solderneer/SimpleMP4/README.md

# SimpleMP4
A custom MP4 player designed based on the Rockwell RK2608 dedicated IC.

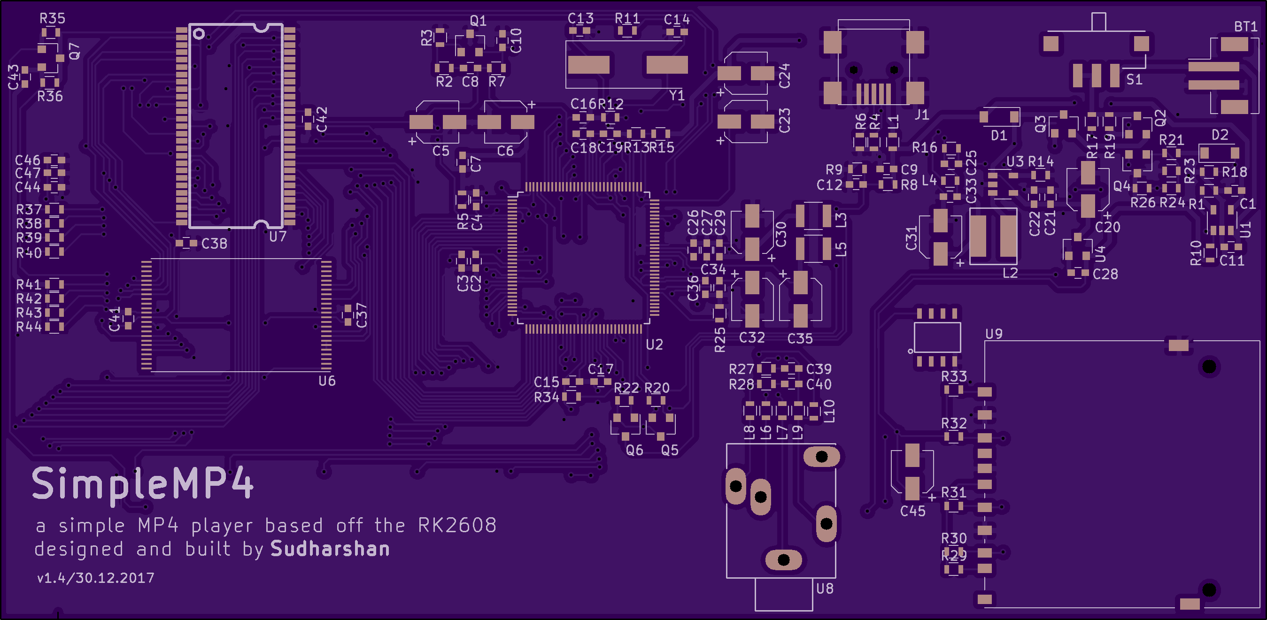
[picture p1: renders/v1.0.0_top.png]
