solderneer/SimpleMP4/renders/v1.0.0_bot.png

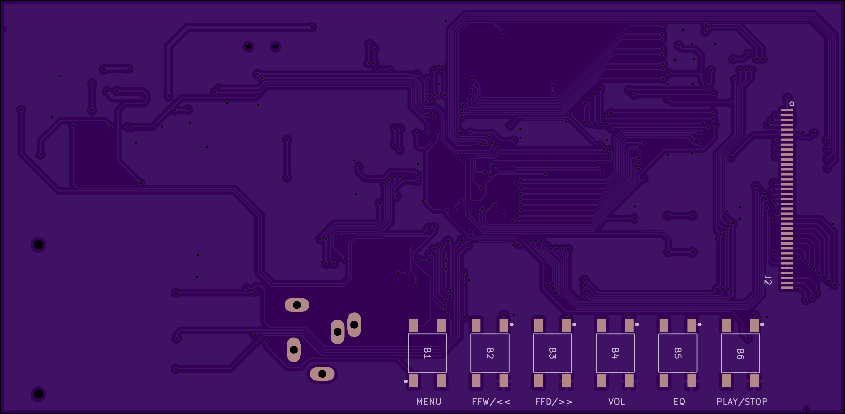
renders/v1.0.0_bot.png
