solderneer/SimpleMP4/electronics/bom/SimpleMP4.csv

Reference | Value | Footprint | Datasheet | Digikey | Quantity | 1276-1021-1-ND | 1
B1 | PLAY/STOP | footprints:SW_HP0315AFKP4-R | SKHLAAA010 | 360-2596-1-ND | 1 | 1N4148W-FDIDKR-ND | 1
B2 | EQ | footprints:SW_HP0315AFKP4-R | SKHLAAA010 | 360-2596-1-ND | 1 | 1N5819HW-FDICT-ND | 1
B3 | VOL | footprints:SW_HP0315AFKP4-R | SKHLAAA010 | 360-2596-1-ND | 1 | 308-1527-1-ND | 1
B4 | FFD/>> | footprints:SW_HP0315AFKP4-R | SKHLAAA010 | 360-2596-1-ND | 1 | 311-10KDCT-ND | 7
B5 | FFW/<< | footprints:SW_HP0315AFKP4-R | SKHLAAA010 | 360-2596-1-ND | 1 | 360-2596-1-ND | 6
B6 | MENU | footprints:SW_HP0315AFKP4-R | SKHLAAA010 | 360-2596-1-ND | 1 | 360-2924-1-ND | 1
BT1 | LI-3.6V | footprints:JST_PH_B2B-PH-SM4-TB_02x2.00mm_Straight |  | 455-1734-2-ND | 1 | 399-1095-1-ND | 23
C1 | 1uF | footprints:C_0603 |  | 399-3118-1-ND | 1 | 399-3118-1-ND | 4
C10 | 0.1uF | footprints:C_0603 |  | 399-1095-1-ND | 1 | 399-9096-1-ND | 2
C11 | 1uF | footprints:C_0603 |  | 399-3118-1-ND | 1 | 445-1272-1-ND | 2
C12 | 0.1uF | footprints:C_0603 |  | 399-1095-1-ND | 1 | 455-1734-2-ND | 1
C13 | 8pF | footprints:C_0603 |  | 445-1272-1-ND | 1 | 478-1227-1-ND | 4
C14 | 8pF | footprints:C_0603 |  | 445-1272-1-ND | 1 | 490-14398-2-ND | 7
C15 | 0.1uF | footprints:C_0603 |  | 399-1095-1-ND | 1 | 535-10233-1-ND | 1
C16 | 0.1uF | footprints:C_0603 |  | 399-1095-1-ND | 1 | 587-3064-1-ND | 2
C17 | 0.1uF | footprints:C_0603 |  | 399-1095-1-ND | 1 | 609-3956-1-ND | 1
C18 | 0.1uF | footprints:C_0603 |  | 399-1095-1-ND | 1 | 609-4700-2-ND | 1
C19 | 1uF | footprints:C_0603 |  | 399-3118-1-ND | 1 | A103049TR-ND | 2
C2 | 0.1uF | footprints:C_0603 |  | 399-1095-1-ND | 1 | A119955TR-ND | 4
C20 | 22uF | footprints:CP_Elec_4x4.5 |  | PCE3857CT-ND | 1 | A119962CT-ND | 1
C21 | 0.1uF | footprints:C_0603 |  | 399-1095-1-ND | 1 | AP2210N-3.3TRG1DICT-ND | 1
C22 | 10nF | footprints:C_0603 |  | 478-1227-1-ND | 1 | MCT0603-33.0-CFCT-ND | 4
C23 | 10uF | footprints:CP_Elec_4x4.5 |  | PCE3878CT-ND | 1 | P12KDBCT-ND | 1
C24 | 10uF | footprints:CP_Elec_4x4.5 |  | PCE3878CT-ND | 1 | P150KDBCT-ND | 1
C25 | 30pF | footprints:C_0603 |  | 1276-1021-1-ND | 1 | P4.7KDBCT-ND | 1
C26 | 0.1uF | footprints:C_0603 |  | 399-1095-1-ND | 1 | P47KDBCT-ND | 8
C27 | 0.1uF | footprints:C_0603 |  | 399-1095-1-ND | 1 | P56KDBCT-ND | 1
C28 | 1uF | footprints:C_0603 |  | 399-3118-1-ND | 1 | PCE3857CT-ND | 11
C29 | 0.1uF | footprints:C_0603 |  | 399-1095-1-ND | 1 | RR08P1.0KDCT-ND | 1
C3 | 0.1uF | footprints:C_0603 |  | 399-1095-1-ND | 1 | RR08P100KDCT-ND | 8
C30 | 10uF | footprints:CP_Elec_4x4.5 |  | PCE3878CT-ND | 1 | RR08P220KDCT-ND | 1
C31 | 10uF | footprints:CP_Elec_4x4.5 |  | PCE3878CT-ND | 1 | WM13342-ND | 1
C32 | 10uF | footprints:CP_Elec_4x4.5 |  | PCE3878CT-ND | 1 |  | 112
C33 | 10nF | footprints:C_0603 |  | 478-1227-1-ND | 1
C34 | 0.1uF | footprints:C_0603 |  | 399-1095-1-ND | 1
C35 | 10uF | footprints:CP_Elec_4x4.5 |  | PCE3878CT-ND | 1
C36 | 0.1uF | footprints:C_0603 |  | 399-1095-1-ND | 1
C37 | 0.1uF | footprints:C_0603 |  | 399-1095-1-ND | 1
C38 | 0.1uF | footprints:C_0603 |  | 399-1095-1-ND | 1
C39 | 47nF | footprints:C_0603 |  | 399-9096-1-ND | 1
C4 | 10nF | footprints:C_0603 |  | 478-1227-1-ND | 1
C40 | 47nF | footprints:C_0603 |  | 399-9096-1-ND | 1
C41 | 0.1uF | footprints:C_0603 |  | 399-1095-1-ND | 1
C42 | 0.1uF | footprints:C_0603 |  | 399-1095-1-ND | 1
C43 | 0.1uF | footprints:C_0603 |  | 399-1095-1-ND | 1
C44 | 0.1uF | footprints:C_0603 |  | 399-1095-1-ND | 1
C45 | 10uF | footprints:CP_Elec_4x4.5 |  | PCE3878CT-ND | 1
C46 | 0.1uF | footprints:C_0603 |  | 399-1095-1-ND | 1
C47 | 10uF | footprints:C_0603 |  | PCE3878CT-ND | 1
C5 | 22uF | footprints:CP_Elec_4x4.5 |  | PCE3857CT-ND | 1
C6 | 22uF | footprints:CP_Elec_4x4.5 |  | PCE3857CT-ND | 1
C7 | 10nF | footprints:C_0603 |  | 478-1227-1-ND | 1
C8 | 0.1uF | footprints:C_0603 |  | 399-1095-1-ND | 1
C9 | 0.1uF | footprints:C_0603 |  | 399-1095-1-ND | 1
D1 | 1N5819 | footprints:D_SOD-123 |  | 1N5819HW-FDICT-ND | 1
D2 | 1N4148 | footprints:D_SOD-123 |  | 1N4148W-FDIDKR-ND | 1
J1 | CONN USB MICRO B | footprints:USB_Mini-B |  | 609-4700-2-ND | 1
J2 | DISPLAY | footprints:KD024B |  | WM13342-ND | 1
L1 | 600R/100M | footprints:L_0603 |  | 490-14398-2-ND | 1
L10 | 600R/100M | footprints:L_0603 |  | 490-14398-2-ND | 1
L2 | 4.7uH | footprints:CR43NP-4R7MC |  | 308-1527-1-ND | 1
L3 | 10uH | footprints:L_1210 |  | 587-3064-1-ND | 1
L4 | 600R/100M | footprints:L_0603 |  | 490-14398-2-ND | 1
L5 | 10uH | footprints:L_1210 |  | 587-3064-1-ND | 1
L6 | 600R/100M | footprints:L_0603 |  | 490-14398-2-ND | 1
L7 | 600R/100M | footprints:L_0603 |  | 490-14398-2-ND | 1
L8 | 600R/100M | footprints:L_0603 |  | 490-14398-2-ND | 1
L9 | 600R/100M | footprints:L_0603 |  | 490-14398-2-ND | 1
R1 | 4.7K | footprints:R_0603 |  | P4.7KDBCT-ND | 1
R10 | 100K | footprints:R_0603 |  | RR08P100KDCT-ND | 1
R11 | 1M | footprints:R_0603 |  | A119955TR-ND | 1
R12 | 100K | footprints:R_0603 |  | RR08P100KDCT-ND | 1
R13 | 100K | footprints:R_0603 |  | RR08P100KDCT-ND | 1
R14 | 150K* | footprints:R_0603 |  | P150KDBCT-ND | 1
R15 | 100K | footprints:R_0603 |  | RR08P100KDCT-ND | 1
R16 | 390K | footprints:R_0603 |  | A119962CT-ND | 1
R17 | 10K | footprints:R_0603 |  | 311-10KDCT-ND | 1
R18 | 100K | footprints:R_0603 |  | RR08P100KDCT-ND | 1
R19 | 100K | footprints:R_0603 |  | RR08P100KDCT-ND | 1
R2 | 220K | footprints:R_0603 |  | RR08P220KDCT-ND | 1
R20 | 1K | footprints:R_0603 |  | RR08P1.0KDCT-ND | 1
R21 | 47K | footprints:R_0603 |  | P47KDBCT-ND | 1
R22 | 100K | footprints:R_0603 |  | RR08P100KDCT-ND | 1
R23 | 100K | footprints:R_0603 |  | RR08P100KDCT-ND | 1
R24 | 47K | footprints:R_0603 |  | P47KDBCT-ND | 1
R25 | 56K/1% | footprints:R_0603 |  | P56KDBCT-ND | 1
R26 | 10K | footprints:R_0603 |  | 311-10KDCT-ND | 1
R27 | 16 | footprints:R_0603 |  | A103049TR-ND | 1
R28 | 16 | footprints:R_0603 |  | A103049TR-ND | 1
R29 | 47K | footprints:R_0603 |  | P47KDBCT-ND | 1
R3 | 1M | footprints:R_0603 |  | A119955TR-ND | 1
R30 | 47K | footprints:R_0603 |  | P47KDBCT-ND | 1
R31 | 47K | footprints:R_0603 |  | P47KDBCT-ND | 1
R32 | 47K | footprints:R_0603 |  | P47KDBCT-ND | 1
R33 | 47K | footprints:R_0603 |  | P47KDBCT-ND | 1
R34 | 47K | footprints:R_0603 |  | P47KDBCT-ND | 1
R35 | 10K | footprints:R_0603 |  | 311-10KDCT-ND | 1
R36 | 10K | footprints:R_0603 |  | 311-10KDCT-ND | 1
R37 | 33R | footprints:R_0603 |  | MCT0603-33.0-CFCT-ND | 1
R38 | 33R | footprints:R_0603 |  | MCT0603-33.0-CFCT-ND | 1
R39 | 33R | footprints:R_0603 |  | MCT0603-33.0-CFCT-ND | 1
R4 | 1M | footprints:R_0603 |  | A119955TR-ND | 1
R40 | 33R | footprints:R_0603 |  | MCT0603-33.0-CFCT-ND | 1
R41 | R* | footprints:R_0603 |  |  | 1
R42 | R* | footprints:R_0603 |  |  | 1
R43 | R* | footprints:R_0603 |  |  | 1
R44 | R* | footprints:R_0603 |  |  | 1
R5 | 10K | footprints:R_0603 |  | 311-10KDCT-ND | 1
R6 | 1M | footprints:R_0603 |  | A119955TR-ND | 1
R7 | 10K | footprints:R_0603 |  | 311-10KDCT-ND | 1
R8 | 10K | footprints:R_0603 |  | 311-10KDCT-ND | 1
R9 | 12K | footprints:R_0603 |  | P12KDBCT-ND | 1
S1 | ON/OFF | footprints:SW_SS312SAH4-R | NKK Switches | 360-2924-1-ND | 1
U1 | OCP8020 | footprints:SOT-23-5 |  |  | 1
U2 | RK2608 | footprints:LQFP-128_14x14mm_Pitch0.4mm | DOCUMENTATION |  | 1
U3 | OCP2150TW18A | footprints:SOT-23-5 |  |  | 1
U4 | OCP1240 | footprints:SOT-23 |  | AP2210N-3.3TRG1DICT-ND | 1
U5 | MT25QL128ABA | footprints:SOP-8 |  |  | 1
U6 | IS34ML04G081-TLI | footprints:TSOP-I-48_18.4x12mm_Pitch0.5mm | DOCUMENTATION |  | 1
U7 | K4S641632N | footprints:TSOP-54 | DOCUMENTATION |  | 1
U8 | TRS_5PIN | footprints:Stereo_Jack_3.5mm_Switch_Ledino_KB3SPRS |  |  | 1
U9 | MMC/SD_SOCKET | footprints:SD_Card_Receptacle |  | 609-3956-1-ND | 1
Y1 | 24MHz | footprints:Crystal_SMD_HC49-SD |  | 535-10233-1-ND | 1
