solderneer/SimpleMP4/electronics/SimpleMP4.kicad_pcb

## KiCad design electronics/SimpleMP4.kicad_pcb (2018-01-05)

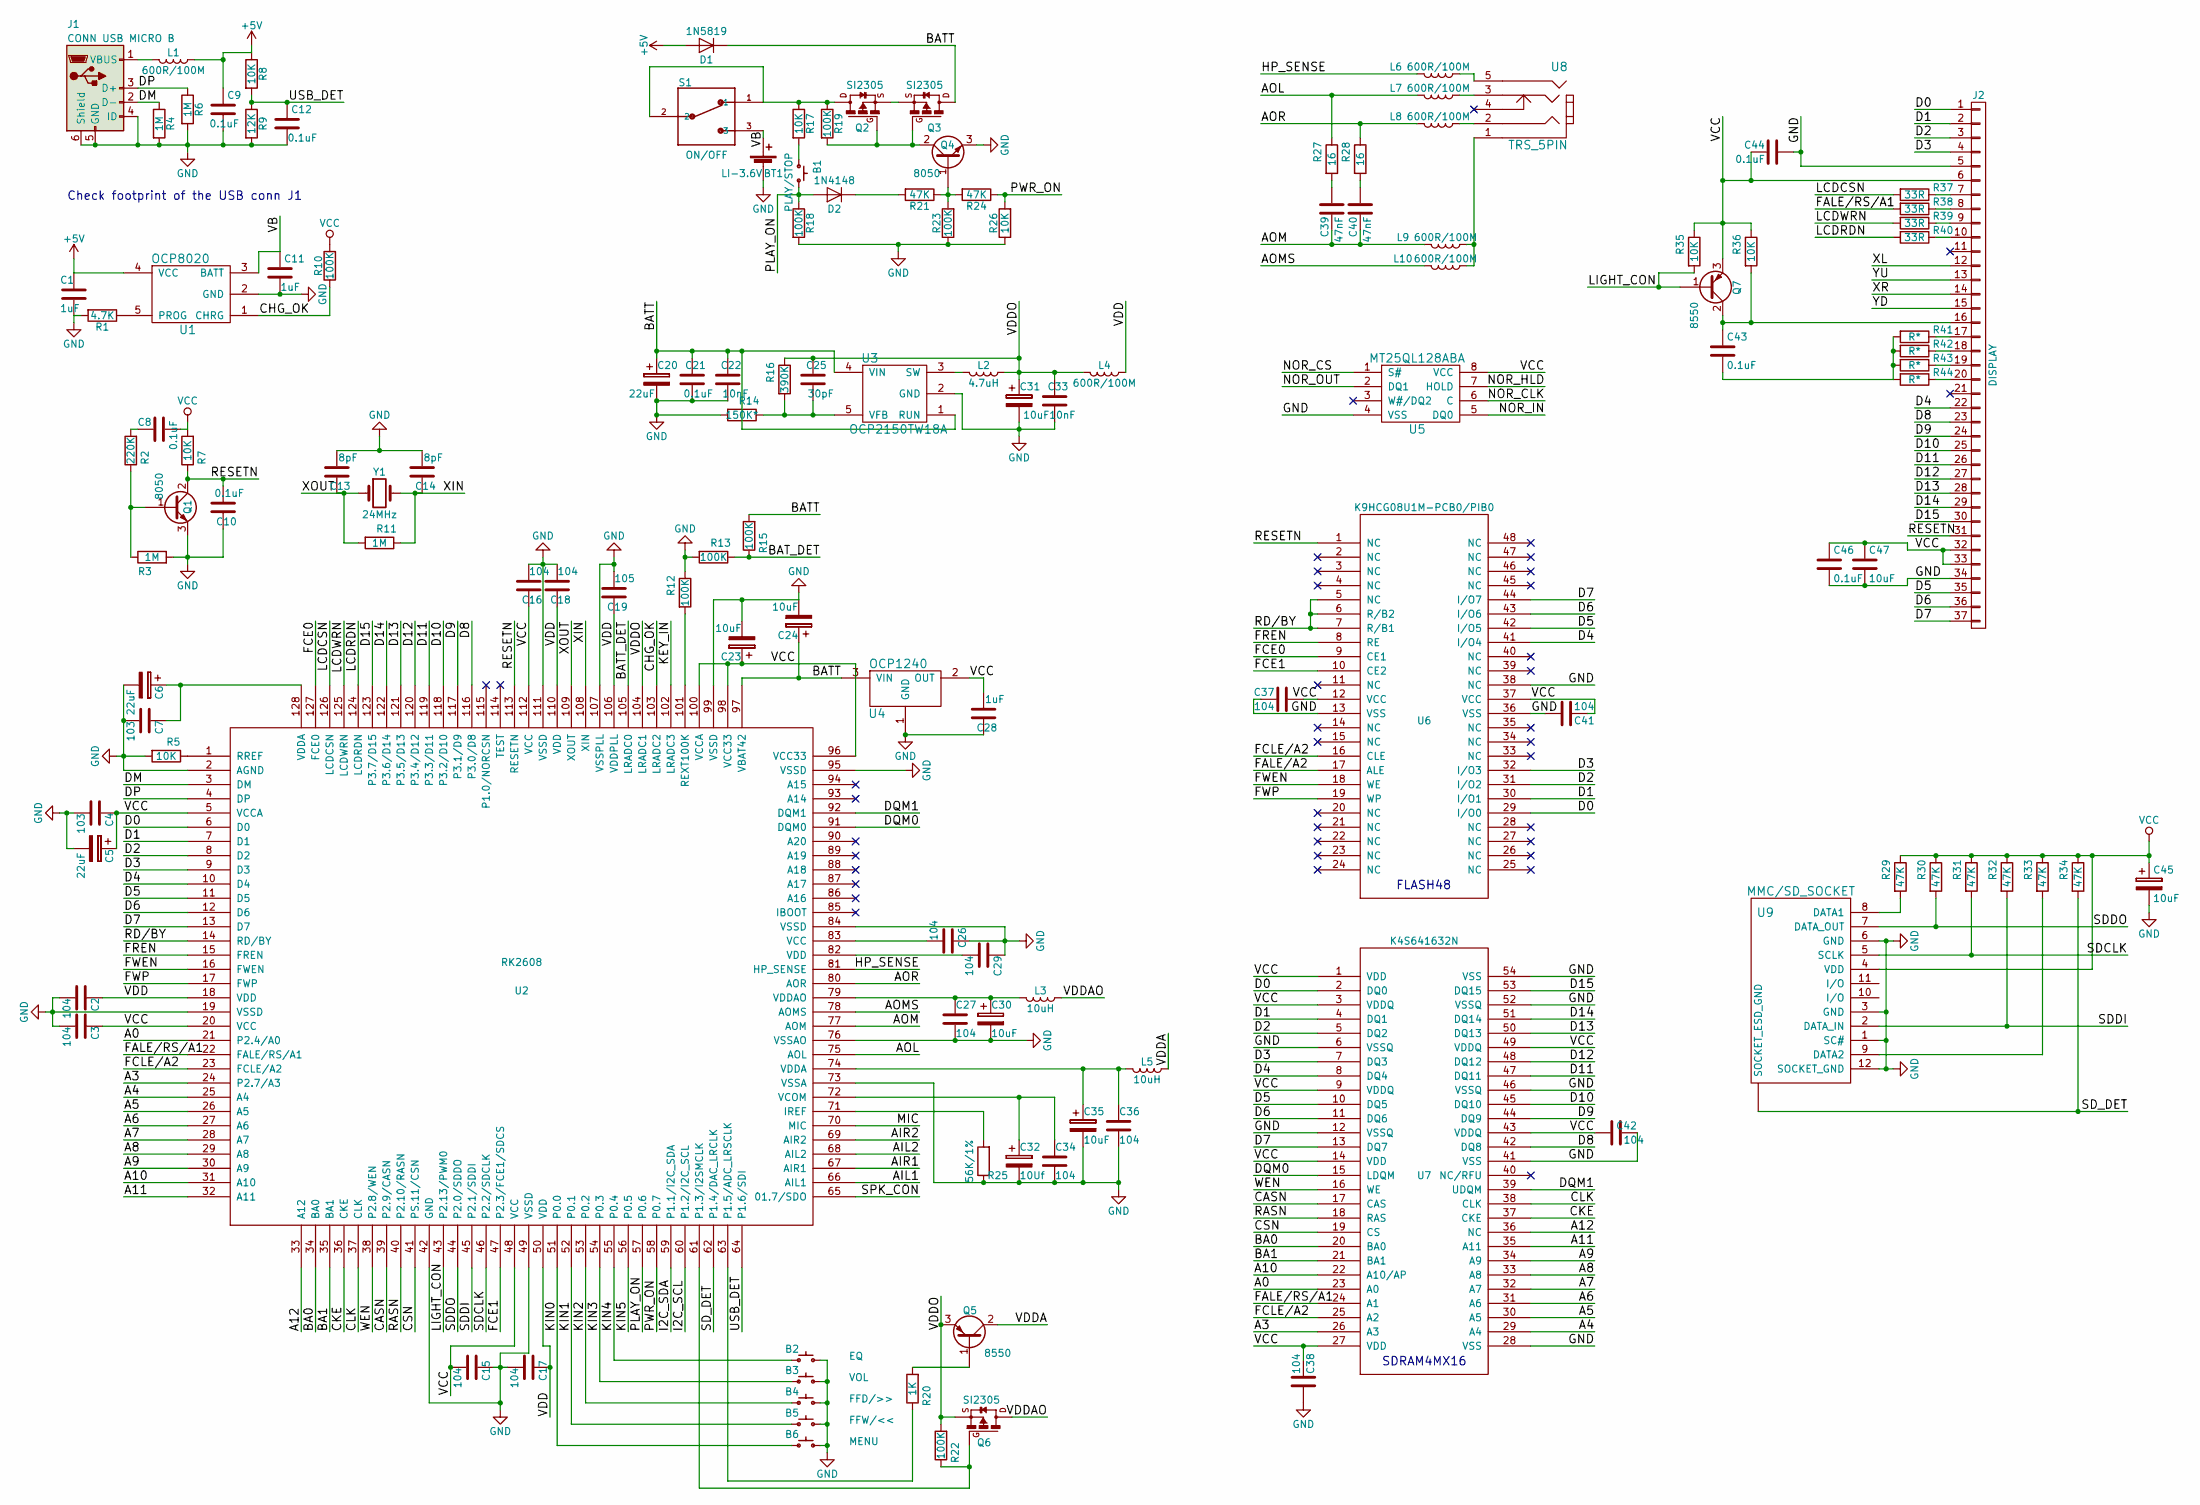
[picture p3: schematic SimpleMP4.sch, MP3 Player]

Parts:
B1: PLAY/STOP; SW_HP0315AFKP4-R
B2: EQ; SW_HP0315AFKP4-R
B3: VOL; SW_HP0315AFKP4-R
B4: FFD/>>; SW_HP0315AFKP4-R
B5: FFW/<<; SW_HP0315AFKP4-R
B6: MENU; SW_HP0315AFKP4-R
BT1: LI-3.6V; JST_PH_B2B-PH-SM4-TB_02x2.00mm_Straight
C1, C11: 1uF; C_0603; Digikey 399-3118-1-ND
C2, C3, C15, C16, C17, C18, C26, C27, C29, C34, C36, C37, C38, C41, C42: 104; C_0603
C4, C7: 103; C_0603
C5, C6: 22uF; CP_Elec_4x4.5
C8, C9, C10, C12, C21, C43, C44, C46: 0.1uF; C_0603; Digikey 399-1095-1-ND
C13, C14: 8pF; C_0603; Digikey 1276-1817-1-ND
C19: 105; C_0603
C20: 22uF; CP_Elec_4x4.5; Digikey PCE3857CT-ND
C22, C33: 10nF; C_0603; Digikey 478-1227-1-ND
C23, C24, C30, C35: 10uF; CP_Elec_4x4.5
C25: 30pF; C_0603; Digikey 1276-1021-1-ND
C28: 1uF; C_0603
C31, C45: 10uF; CP_Elec_4x4.5; Digikey PCE3878CT-ND
C32: 10Uf; CP_Elec_4x4.5
C39, C40: 47nF; C_0603; Digikey 399-9096-1-ND
C47: 10uF; C_0603
D1: 1N5819; D_SOD-123; Digikeyy 1N5819HW-FDICT-ND
D2: 1N4148; D_SOD-123; Digikey 1N4148W-FDIDKR-ND
J1: CONN USB MICRO B; USB_Mini-B; Digikey 609-4613-2-ND
J2: DISPLAY; KD024B
L1, L4, L6, L7, L8, L9, L10: 600R/100M; L_0603; Digikey 490-14398-2-ND
L2: 4.7uH; CR43NP-4R7MC; Digikey 308-1527-1-ND
L3, L5: 10uH; L_1210
Q1, Q4: 8050; SOT-23; Digikey MMSS8050-H-TPMSCT-ND
Q2, Q3, Q6: SI2305; SOT-23
Q5, Q7: 8550; SOT-23
R1: 4.7K; R_0603
R2: 220K; R_0603; Digikey RR08P220KDCT-ND
R3, R4, R6, R11: 1M; R_0603; Digikey A119955TR-ND
R5: 10K; R_0603
R7, R8, R17, R26, R35, R36: 10K; R_0603; Digikey 311-10KDCT-ND
R9: 12K; R_0603; Digikey P12KDBCT-ND
R10, R18, R19, R23: 100K; R_0603; Digikey RR08P100KDCT-ND
R12, R13, R15, R22: 100K; R_0603
R14: 150K*; R_0603; Digikey P150KDBCT-ND
R16: 390K; R_0603; Digikey A119962CT-ND
R20: 1K; R_0603
R21, R24, R29, R30, R31, R32, R33, R34: 47K; R_0603; Digikey P47KDBCT-ND
R25: 56K/1%; R_0603
R27, R28: 16; R_0603; Digikey A103049TR-ND
R37, R38, R39, R40: 33R; R_0603; Digikey MCT0603-33.0-CFCT-ND
R41, R42, R43, R44: R*; R_0603
S1: ON/OFF; SW_SS312SAH4-R
U1: OCP8020; SOT-23-5
U2: RK2608; LQFP-128_14x14mm_Pitch0.4mm
U3: OCP2150TW18A; SOT-23-5
U4: OCP1240; SOT-23
U5: MT25QL128ABA; SOP-8
U6: K9HCG08U1M-PCB0/PIB0; TSOP-I-48_18.4x12mm_Pitch0.5mm
U7: K4S641632N; TSOP-54
U8: TRS_5PIN; Stereo_Jack_3.5mm_Switch_Ledino_KB3SPRS
U9: MMC/SD_SOCKET; SD_Card_Receptacle
Y1: 24MHz; Crystal_SMD_HC49-SD; Digikey 535-10233-1-ND

Connections:
+5V: C1.1, C9.1, D1.2 (A), L1.1, R8.1, U1.4 (VCC)
/A0: U2.21 (P2.4/A0), U7.23 (A0)
/A3: U2.24 (P2.7/A3), U7.26 (A3)
/A4: U2.25 (A4), U7.29 (A4)
/A5: U2.26 (A5), U7.30 (A5)
/A6: U2.27 (A6), U7.31 (A6)
/A7: U2.28 (A7), U7.32 (A7)
/A8: U2.29 (A8), U7.33 (A8)
/A9: U2.30 (A9), U7.34 (A9)
/A10: U2.31 (A10), U7.22 (A10/AP)
/A11: U2.32 (A11), U7.35 (A11)
/A12: U2.33 (A12), U7.36 (NC)
/AIL1: U2.66 (AIL1)
/AIL2: U2.68 (AIL2)
/AIR1: U2.67 (AIR1)
/AIR2: U2.69 (AIR2)
/AOL: L7.2, R27.1, U2.75 (AOL)
/AOM: C39.1, C40.1, L9.2, U2.77 (AOM)
/AOMS: L10.2, U2.78 (AOMS)
/AOR: L8.2, R28.1, U2.80 (AOR)
/BA0: U2.34 (BA0), U7.20 (BA0)
/BA1: U2.35 (BA1), U7.21 (BA1)
/BATT: C20.1, C21.2, C22.2, C24.1, D1.1 (K), Q3.3 (D), R15.2, U2.97 (VBAT42), U3.1 (RUN), U3.4 (VIN), U4.3 (VIN)
/BATT_DET: U2.105 (LRADC0)
/BAT_DET: R13.1, R15.1
/CASN: U2.39 (P2.9/CASN), U7.17 (CAS)
/CHG_OK: R10.1, U1.1 (CHRG), U2.103 (LRADC2)
/CKE: U2.36 (CKE), U7.37 (CKE)
/CLK: U2.37 (CLK), U7.38 (CLK)
/CSN: U2.41 (PS.11/CSN), U7.19 (CS)
/D0: J2.1, U2.6 (D0), U6.29 (I/O0), U7.2 (DQ0)
/D1: J2.2, U2.7 (D1), U6.30 (I/O1), U7.4 (DQ1)
/D2: J2.3, U2.8 (D2), U6.31 (I/O2), U7.5 (DQ2)
/D3: J2.4, U2.9 (D3), U6.32 (I/O3), U7.7 (DQ3)
/D4: J2.22, U2.10 (D4), U6.41 (I/O4), U7.8 (DQ4)
/D5: J2.35, U2.11 (D5), U6.42 (I/O5), U7.10 (DQ5)
/D6: J2.36, U2.12 (D6), U6.43 (I/O6), U7.11 (DQ6)
/D7: J2.37, U2.13 (D7), U6.44 (I/O7), U7.13 (DQ7)
/D8: J2.23, U2.116 (P3.0/D8), U7.42 (DQ8)
/D9: J2.24, U2.117 (P3.1/D9), U7.44 (DQ9)
/D10: J2.25, U2.118 (P3.2/D10), U7.45 (DQ10)
/D11: J2.26, U2.119 (P3.3/D11), U7.47 (DQ11)
/D12: J2.27, U2.120 (P3.4/D12), U7.48 (DQ12)
/D13: J2.28, U2.121 (P3.5/D13), U7.50 (DQ13)
/D14: J2.29, U2.122 (P3.6/D14), U7.51 (DQ14)
/D15: J2.30, U2.123 (P3.7/D15), U7.53 (DQ15)
/DM: J1.2 (D-), R4.1, U2.3 (DM)
/DP: J1.3 (D+), R6.1, U2.4 (DP)
/DQM0: U2.91 (DQM0), U7.15 (LDQM)
/DQM1: U2.92 (DQM1), U7.39 (UDQM)
/FALE/A2: U6.17 (ALE)
/FALE/RS/A1: R38.2, U2.22 (FALE/RS/A1), U7.24 (A1)
/FCE0: U2.127 (FCE0), U6.9 (CE1)
/FCE1: U2.47 (P2.3/FCE1/SDCS), U6.10 (CE2)
/FCLE/A2: U2.23 (FCLE/A2), U6.16 (CLE), U7.25 (A2)
/FREN: U2.15 (FREN), U6.8 (RE)
/FWEN: U2.16 (FWEN), U6.18 (WE)
/FWP: U2.17 (FWP), U6.19 (WP)
/HP_SENSE: L6.2, U2.81 (HP_SENSE)
/I2C_SCL: U2.60 (P1.2/I2C_SCL)
/I2C_SDA: U2.59 (P1.1/I2C_SDA)
/KEY_IN: U2.102 (LRADC3)
/KIN0: B6.1, U2.51 (P0.0)
/KIN1: B5.1, U2.52 (P0.1)
/KIN2: B4.1, U2.53 (P0.2)
/KIN3: B3.1, U2.54 (P0.3)
/KIN4: B2.1, U2.55 (P0.4)
/KIN5: U2.56 (P0.5)
/LCDCSN: R37.2, U2.126 (LCDCSN)
/LCDRDN: R40.2, U2.124 (LCDRDN)
/LCDWRN: R39.2, U2.125 (LCDWRN)
/LIGHT_CON: Q7.1 (B), R35.2, U2.43 (P2.13/PWM0)
/MIC: U2.70 (MIC)
/NOR_CLK: U5.6 (C)
/NOR_CS: U5.1 (S#)
/NOR_HLD: U5.7 (HOLD)
/NOR_IN: U5.5 (DQ0)
/NOR_OUT: U5.2 (DQ1)
/PLAY_ON: B1.2, D2.2 (A), R18.1, U2.57 (P0.6)
/PWR_ON: R24.1, R26.2, U2.58 (P0.7)
/RASN: U2.40 (P2.10/RASN), U7.18 (RAS)
/RD/BY: U2.14 (RD/BY), U6.5 (NC), U6.6 (R/B2), U6.7 (R/B1)
/RESETN: C10.2, J2.31, Q1.2 (C), R7.1, U2.113 (RESETN), U6.1 (NC)
/SDCLK: R31.2, U2.46 (P2.2/SDCLK), U9.5 (SCLK)
/SDDI: R32.2, U2.45 (P2.1/SDDI), U9.2 (DATA_IN)
/SDDO: R30.2, U2.44 (P2.0/SDDO), U9.7 (DATA_OUT)
/SD_DET: R34.2, U2.62 (P1.4/DAC_LRCLK), U9.~ (SOCKET_ESD_GND)
/SPK_CON: U2.65 (01.7/SDO)
/USB_DET: C12.1, R8.2, R9.1, U2.64 (P1.6/SDI)
/VB: BT1.1 (+), C11.1, S1.3, U1.3 (BATT)
/VDD: C2.2, C17.2, C18.1, C19.1, L4.1, U2.18 (VDD), U2.50 (VDD), U2.106 (VDDPLL), U2.110 (VDD)
/VDDA: L5.1, Q5.2 (C)
/VDDAO: L3.1, Q6.3 (D)
/VDDO: C25.2, C31.1, C33.2, L2.1, L4.2, Q5.3 (E), Q6.2 (S), R16.1, R22.2, U2.104 (LRADC1)
/WEN: U2.38 (P2.8/WEN), U7.16 (WE)
/XIN: C14.1, R11.1, U2.108 (XIN), Y1.2
/XL: J2.12
/XOUT: C13.1, R11.2, U2.109 (XOUT), Y1.1
/XR: J2.14
/YD: J2.15
/YU: J2.13
GND: B2.2, B3.2, B4.2, B5.2, B6.2, BT1.2 (-), C1.2, C2.1, C3.1, C4.1, C5.2, C6.2, C7.1, C9.2, C10.1, C11.2, C12.2, C13.2, C14.2, C15.2, C16.2, C17.1, C18.2, C19.2, C20.2, C21.1, C22.1, C23.2, C24.2, C26.1, C27.2, C28.1, C29.1, C30.2, C31.2, C32.2, C33.1, C34.2, C35.2, C36.2, C37.1, C38.2, C41.2, C42.2, C44.2, C45.2, C46.2, C47.2, J1.4 (ID), J1.5 (GND), J1.6 (Shield), J2.5, J2.34, Q1.3 (E), Q4.3 (E), R1.2, R3.2, R4.2, R5.2, R6.2, R9.2, R12.1, R13.2, R14.2, R18.2, R23.1, R25.1, R26.1, U1.2 (GND), U2.2 (AGND), U2.19 (VSSD), U2.42 (GND), U2.49 (VSSD), U2.73 (VSSA), U2.76 (VSSAO), U2.84 (VSSD), U2.95 (VSSD), U2.99 (VSSD), U2.107 (VSSPLL), U2.111 (VSSD), U3.2 (GND), U4.1 (GND), U5.4 (VSS), U6.13 (VSS), U6.36 (VSS), U6.38 (NC), U7.6 (VSSQ), U7.12 (VSSQ), U7.28 (VSS), U7.41 (VSS), U7.46 (VSSQ), U7.52 (VSSQ), U7.54 (VSS), U9.1 (SC#), U9.3 (GND), U9.6 (GND), U9.12 (SOCKET_GND)
unnamed: B1.1, R17.2
unnamed: C6.1, C7.2, U2.128 (VDDA)
unnamed: C8.1, R2.2
unnamed: C25.1, R14.1, R16.2, U3.5 (VFB)
unnamed: C26.2, U2.83 (VCC)
unnamed: C27.1, C30.1, L3.2, U2.79 (VDDAO)
unnamed: C29.2, U2.82 (VDD)
unnamed: C32.1, C34.1, U2.72 (VCOM)
unnamed: C35.1, C36.1, L5.2, U2.74 (VDDA)
unnamed: C39.2, R27.2
unnamed: C40.2, R28.2
unnamed: C43.1, J2.16, Q7.2 (C), R36.2
unnamed: C43.2, R41.2, R42.2, R43.2, R44.2
unnamed: D2.1 (K), R21.2
unnamed: J1.1 (VBUS), L1.2
unnamed: J2.7, R37.1
unnamed: J2.8, R38.1
unnamed: J2.9, R39.1
unnamed: J2.10, R40.1
unnamed: J2.17, R41.1
unnamed: J2.18, R42.1
unnamed: J2.19, R43.1
unnamed: J2.20, R44.1
unnamed: L2.2, U3.3 (SW)
unnamed: L6.1, U8.5
unnamed: L7.1, U8.3
unnamed: L8.1, U8.2
unnamed: L9.1, L10.1, U8.1
unnamed: Q1.1 (B), R2.1, R3.1
unnamed: Q2.1 (G), Q3.1 (G), Q4.2 (C), R19.2
unnamed: Q2.2 (S), Q3.2 (S)
unnamed: Q2.3 (D), R17.1, R19.1, S1.1, S1.2
unnamed: Q4.1 (B), R21.1, R23.2, R24.2
unnamed: Q5.1 (B), R20.2
unnamed: Q6.1 (G), R22.1, U2.61 (P1.3/I2SMCLK)
unnamed: R1.1, U1.5 (PROG)
unnamed: R5.1, U2.1 (RREF)
unnamed: R12.2, U2.101 (REXT100K)
unnamed: R20.1, U2.63 (P1.5/ADC_LRSCLK)
unnamed: R25.2, U2.71 (IREF)
unnamed: R29.2, U9.8 (DATA1)
unnamed: R33.2, U9.9 (DATA2)
VCC: C3.2, C4.2, C5.1, C8.2, C15.1, C16.1, C23.1, C28.2, C37.2, C38.1, C41.1, C42.1, C44.1, C45.1, C46.1, C47.1, J2.6, J2.32, J2.33, Q7.3 (E), R7.2, R10.2, R29.1, R30.1, R31.1, R32.1, R33.1, R34.1, R35.1, R36.1, U2.5 (VCCA), U2.20 (VCC), U2.48 (VCC), U2.96 (VCC33), U2.98 (VCC33), U2.100 (VCCA), U2.112 (VCC), U4.2 (OUT), U5.8 (VCC), U6.12 (VCC), U6.37 (VCC), U7.1 (VDD), U7.3 (VDDQ), U7.9 (VDDQ), U7.14 (VDD), U7.27 (VDD), U7.43 (VDDQ), U7.49 (VDDQ), U9.4 (VDD)

Notes on the sheet:
Check footprint of the USB conn J1
FLASH48
SDRAM4MX16

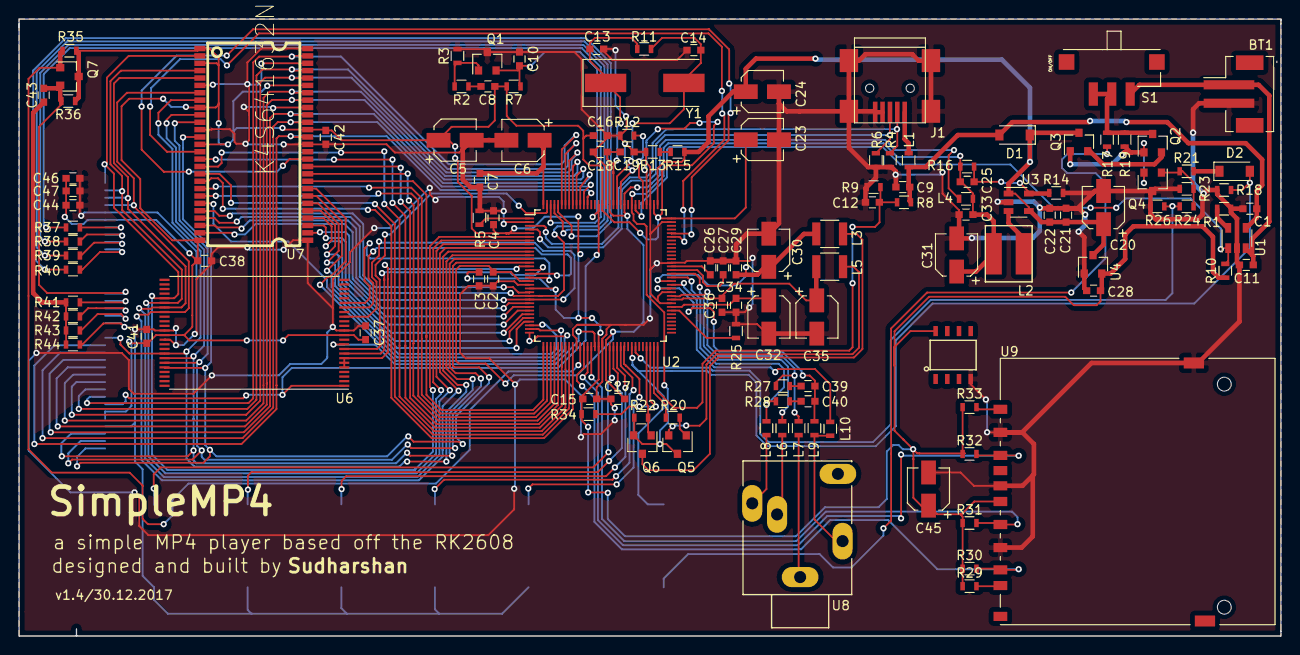
[picture p4: board SimpleMP4.kicad_pcb from above]

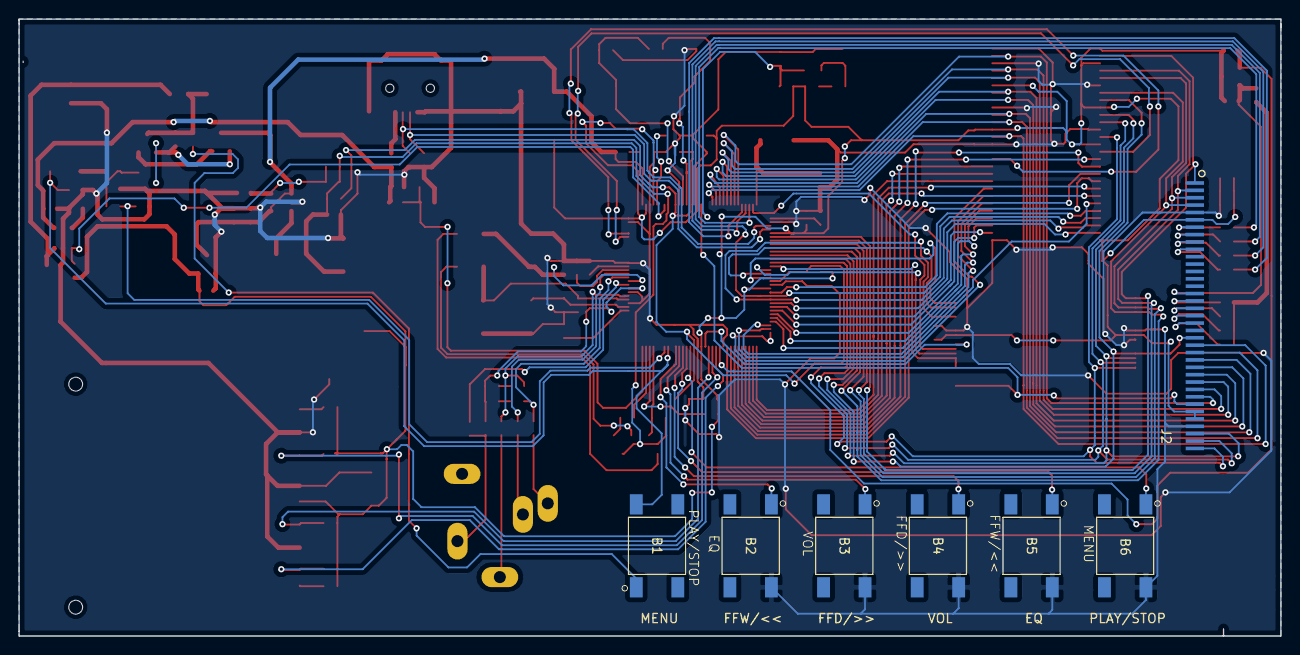
[picture p5: board SimpleMP4.kicad_pcb from below]

Board: 2 copper layers, 136.9 x 66.9 mm, 130 parts (7 on the bottom side), 124 nets.
