solderneer/SimpleMP4/source_code/BulkOnly.h

/********************************************************************************
*********************************************************************************
			COPYRIGHT (c)   2004 BY ROCK-CHIP FUZHOU
				--  ALL RIGHTS RESERVED  --

File Name:	BulkOnly.h
Author:		XUESHAN LIN
Created:		29th SEP 2004
Modified:
Revision:		1.00
********************************************************************************
********************************************************************************/

#ifndef _BULKONLY_H
#define _BULKONLY_H

//1可配置参数
#define 	MAX_LUN		(FLASH_DISK+CD_ROM+SD_CARD_EN)	/*最大支持的逻辑设备数*/

//1常量定义

#define	MAX_CDBLEN      				0x10		//最长的CBW长度

/*******************************************************************
CSW返回状态值
*******************************************************************/
#define	CSW_GOOD					0x00		//命令通过
#define	CSW_FAIL					0x01		//命令失败
#define	CSW_PHASE_ERROR			0x02		//命令有误
/*******************************************************************
Bulk Only传输阶段
*******************************************************************/
#define	K_CommandPhase			0x00
#define	K_OutDataPhase				0x01
#define 	K_OutDataPhaseWrite		0x02
#define 	K_OutResponsePhase			0x03
#define 	K_InDataPhase				0x81
#define 	K_InDataPhaseRead			0x82
#define 	K_InResponsePhase			0x83
#define 	K_InCompletionPhase		0x84
#define 	K_XferDirMask				0x80
#define 	K_InCSWPhase				0x08
/*******************************************************************
Bulk Only命令集
*******************************************************************/
#define 	K_SCSICMD_TEST_UNIT_READY					0x00
#define 	K_SCSICMD_REZERO_UNIT						0x01
#define 	K_SCSICMD_REQUEST_SENSE						0x03
#define 	K_SCSICMD_FORMAT_UNIT						0x04
#define 	K_SCSICMD_INQUIRY								0x12
#define 	K_SCSICMD_MODE_SENSE_06						0x1a
#define 	K_SCSICMD_START_STOP_UNIT					0x1b
#define 	K_SCSICMD_SEND_DIAGNOSTIC					0x1d
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
