solderneer/SimpleMP4/(commit log)

2017-11-22 pulling pre existing firmware and docs
    [QVGA.cfg, QVGA_1.cfg]
2017-12-12 added kicad project
    [SimpleMP4.kicad_pcb, SimpleMP4.sch]
2017-12-12 added USB section
    [SimpleMP4.sch]
2017-12-12 added power processing section
    [SimpleMP4.sch]
2017-12-12 added FM section and spk amp section
    [SimpleMP4.sch]
2017-12-13 added SD card section
    [SimpleMP4.sch]
2017-12-13 added ocp21050 section
    [SimpleMP4.sch]
2017-12-13 added display header
    [SimpleMP4.sch]
2017-12-14 added SDRAM and FLASH datasheets
    [SimpleMP4.sch]
2017-12-15 added flash section
    [SimpleMP4.sch]
2017-12-15 added SDRAM
    [SimpleMP4.sch]
2017-12-15 fixed some errors
    [SimpleMP4.sch]
2017-12-15 added RK2608
    [SimpleMP4.sch]
2017-12-15 finished RK2608 section
    [SimpleMP4.sch]
2017-12-15 added batt to poower processing circuitry
    [SimpleMP4.sch]
2017-12-17 updated datasheets
    [SimpleMP4.sch]
2017-12-17 added annotations to components
    [SimpleMP4.sch]
2017-12-18 added proper display and LCD backlight driver
    [SimpleMP4.sch]
2017-12-18 added TRS 5pin audio jack section
    [SimpleMP4.sch]
2017-12-18 added NOR Flash chip
    [SimpleMP4.sch]
2017-12-18 added annotations and bom
    [SimpleMP4.sch]
2017-12-18 cleaning up schematic
    [SimpleMP4.sch]
2017-12-18 added proper BOM for client
    [SimpleMP4.sch]
2017-12-20 fixed error in schematics
    [SimpleMP4.sch]
2017-12-22 added netlist
    [SimpleMP4.sch]
2017-12-22 finalizing part values
    [SimpleMP4.sch]
2017-12-22 updated schematics
    [SimpleMP4.sch]
2017-12-22 added footprints
2017-12-23 placing components around RK2608
    [SimpleMP4.kicad_pcb]
2017-12-23 placed most components around rk2608
    [SimpleMP4.kicad_pcb, SimpleMP4.sch]
2017-12-23 fixed minor error in schematic'
    [SimpleMP4.sch]
2017-12-24 placed USB section
    [SimpleMP4.kicad_pcb]
2017-12-24 grouped a few more components
    [SimpleMP4.kicad_pcb]
2017-12-24 added display connector
    [SimpleMP4.sch]
2017-12-25 updated SOP8 footprint
2017-12-25 placed more components and defined board edge
    [SimpleMP4.kicad_pcb, SimpleMP4.sch]
2017-12-25 pausing for now
    [SimpleMP4.kicad_pcb, SimpleMP4.sch]
2017-12-25 added inductor footprints and starting to route
    [SimpleMP4.kicad_pcb]
2017-12-25 that's it for today
    [SimpleMP4.kicad_pcb]
2017-12-25 added partial routing
    [SimpleMP4.kicad_pcb, SimpleMP4.sch]
2017-12-26 routed most major parallel buses
    [SimpleMP4.kicad_pcb]
2017-12-28 cleaned up power section
    [SimpleMP4.kicad_pcb]
2017-12-28 added spst tactile switch footprint
    [SimpleMP4.kicad_pcb]
2017-12-28 added test points
    [SimpleMP4.sch]
2017-12-28 added another data bus
    [SimpleMP4.kicad_pcb, SimpleMP4.sch]
2017-12-28 routed more of it
    [SimpleMP4.kicad_pcb]
2017-12-28 routed more of the segments
    [SimpleMP4.kicad_pcb]
2017-12-28 added routing to buttons
    [SimpleMP4.kicad_pcb, SimpleMP4.sch]
2017-12-29 94 unconnected left
    [SimpleMP4.kicad_pcb, SimpleMP4.sch]
2017-12-29 routed more connections
    [SimpleMP4.kicad_pcb]
2017-12-29 routed headphone jack
    [SimpleMP4.kicad_pcb]
2017-12-29 routed most connections
    [SimpleMP4.kicad_pcb]
2017-12-29 done routing
    [SimpleMP4.kicad_pcb]
2017-12-29 added filled zones
    [SimpleMP4.kicad_pcb]
2017-12-29 proper silkscreen
    [SimpleMP4.kicad_pcb]
2017-12-29 added back filled zones
    [SimpleMP4.kicad_pcb]
2017-12-30 generated gerber files
    [SimpleMP4-B.Cu.gbr, SimpleMP4-B.Mask.gbr, SimpleMP4-B.SilkS.gbr, SimpleMP4-Edge.Cuts.gbr, SimpleMP4-F.Cu.gbr, SimpleMP4-F.Mask.gbr, SimpleMP4-F.SilkS.gbr, SimpleMP4.drl]
2017-12-30 creating footprints.pretty to hold used footprints
    [SimpleMP4.kicad_pcb]
2017-12-30 changed fp-lib-table to match new footprint locations
2017-12-30 added OSHpark renders
    [SimpleMP4.kicad_pcb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]
2017-12-30 moved silkscreen
    [SimpleMP4.kicad_pcb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]
2017-12-30 moved silkscreen of battery conn and switch
    [SimpleMP4.kicad_pcb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]
2018-01-03 added new gerber files
    [SimpleMP4-B.Cu.gbr, SimpleMP4-B.Mask.gbr, SimpleMP4-B.SilkS.gbr, SimpleMP4-Edge.Cuts.gbr, SimpleMP4-F.Cu.gbr, SimpleMP4-F.Mask.gbr, SimpleMP4-F.SilkS.gbr, SimpleMP4.drl]
2018-01-03 labelling components with digikey part number
    [SimpleMP4.sch]
2018-01-05 updating versioning details on PCB
    [SimpleMP4-B.Cu.gbr, SimpleMP4-B.Mask.gbr, SimpleMP4-B.SilkS.gbr, SimpleMP4-Edge.Cuts.gbr, SimpleMP4-F.Cu.gbr, SimpleMP4-F.Mask.gbr, SimpleMP4-F.SilkS.gbr, SimpleMP4.drl]
2018-01-08 changed out FLASH chip
    [SimpleMP4.sch]
2018-01-08 added BOM to repo
    [SimpleMP4.csv]
2018-01-09 added condensed BOM
    [SimpleMP4.csv]
2018-01-09 added BOM folder
    [SimpleMP4.csv]
2018-01-09 added bom files
    [SimpleMP4.csv, order_1.csv]
